Thecactusman0/ES8327-Breakout/Kicad/3D models/1.44in SPI LCD Module - No Glass.stp

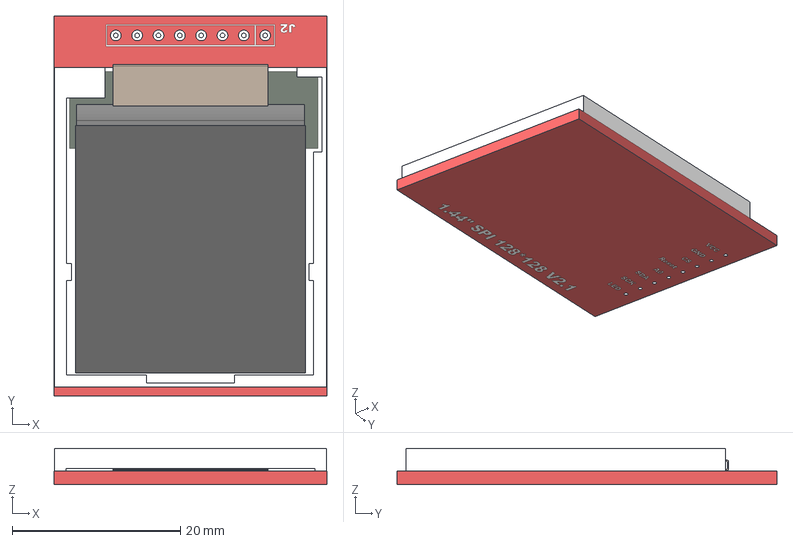
[picture p1: CAD file, 2023-06-25]
Kicad/3D models/1.44in SPI LCD Module - No Glass.stp
32.5 x 45.2 x 4.32 mm
