Thecactusman0/ES8327-Breakout/Kicad/3D models/Audio socket.step

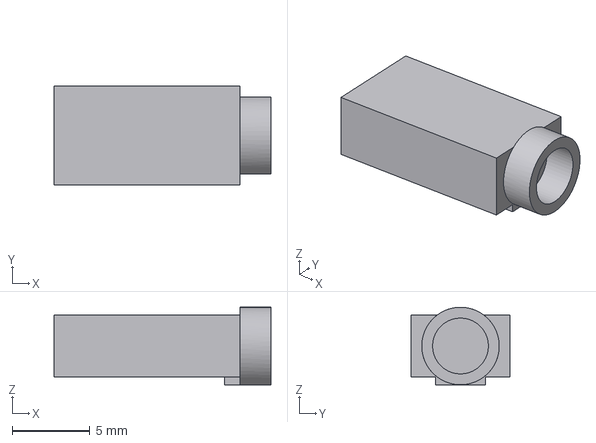
[picture p2: CAD file, 2023-06-25]
Kicad/3D models/Audio socket.step
14.0 x 6.40 x 5.00 mm
