Thecactusman0/ES8327-Breakout/Kicad/3D models/u262-16xn-4bvc11.stp

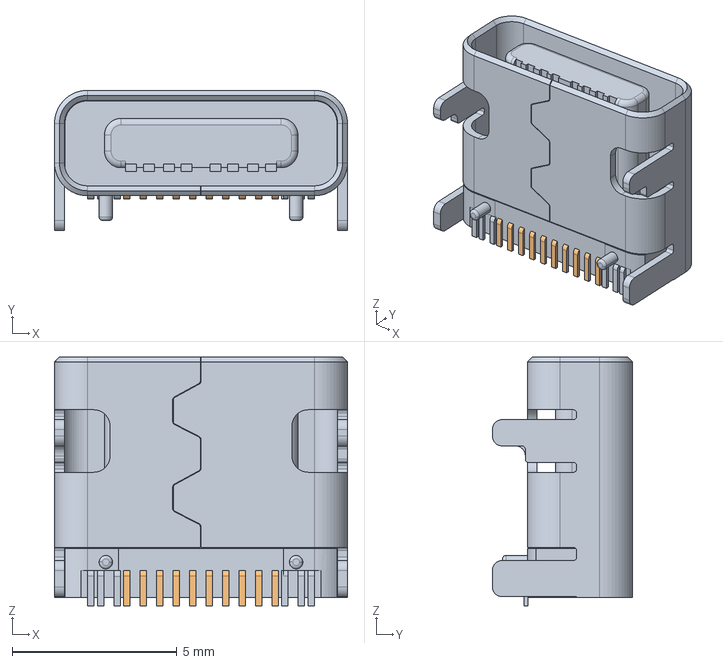
[picture p3: CAD file, 2023-06-25]
Kicad/3D models/u262-16xn-4bvc11.stp
8.90 x 4.26 x 7.56 mm
