Thecactusman0/ES8327-Breakout/Kicad/3D models/Spk.step

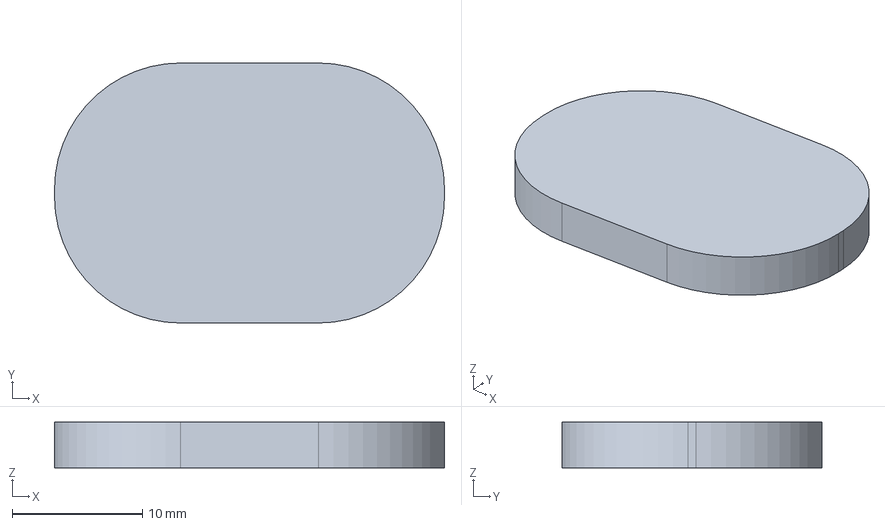
[picture p4: CAD file, 2023-06-25]
Kicad/3D models/Spk.step
30.0 x 20.0 x 3.50 mm
