Thecactusman0/ES8327-Breakout/Kicad/3D models/Mic.step

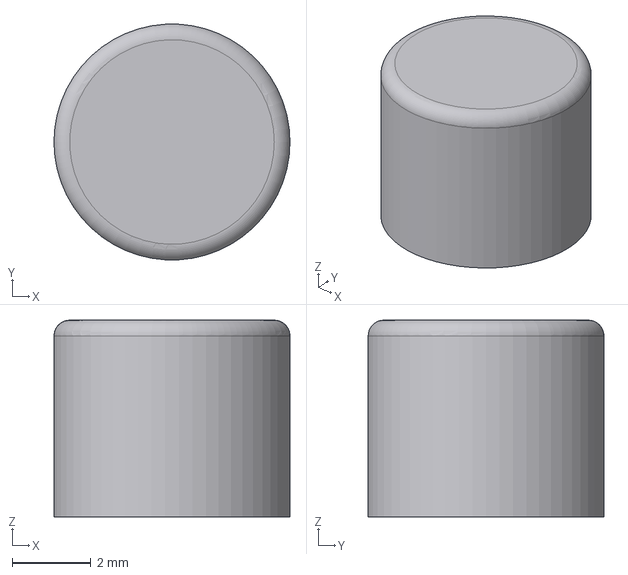
[picture p5: CAD file, 2023-06-25]
Kicad/3D models/Mic.step
6.00 x 5.99 x 5.00 mm
