Thecactusman0/ES8327-Breakout/Kicad/3D models/KMR221GLFS--3DModel-STEP-56544.STEP

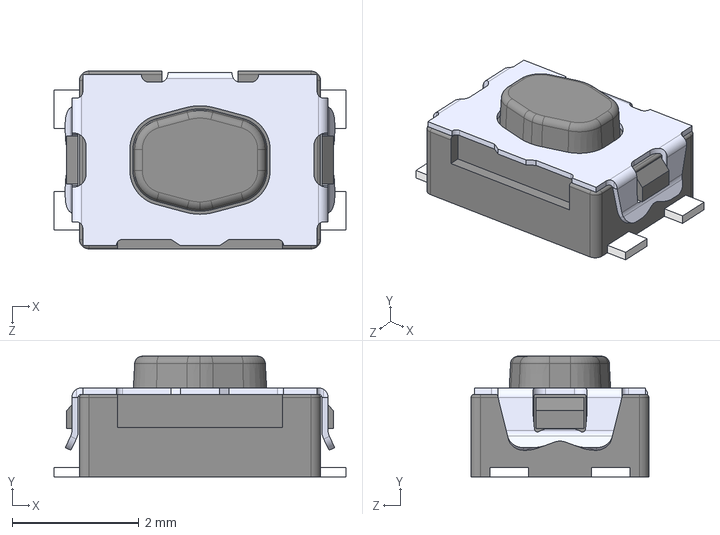
[picture p6: CAD file, 2023-06-25]
Kicad/3D models/KMR221GLFS--3DModel-STEP-56544.STEP
4.60 x 1.90 x 2.80 mm
