Thecactusman0/ES8327-Breakout/Kicad/3D models/104031-0811.stp

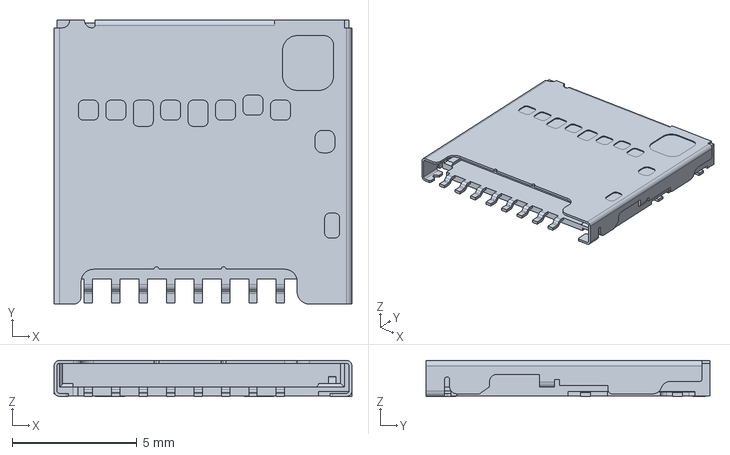
[picture p7: CAD file, 2023-06-25]
Kicad/3D models/104031-0811.stp
11.9 x 11.4 x 1.45 mm
