Thecactusman0/ES8327-Breakout/(list of files, cad)

Other CAD files:
Kicad/3D models/8967560.stp
