Thecactusman0/ES8327-Breakout/Kicad/Audio test board.kicad_sch

## KiCad design Kicad/Audio test board.kicad_sch (2023-06-25)

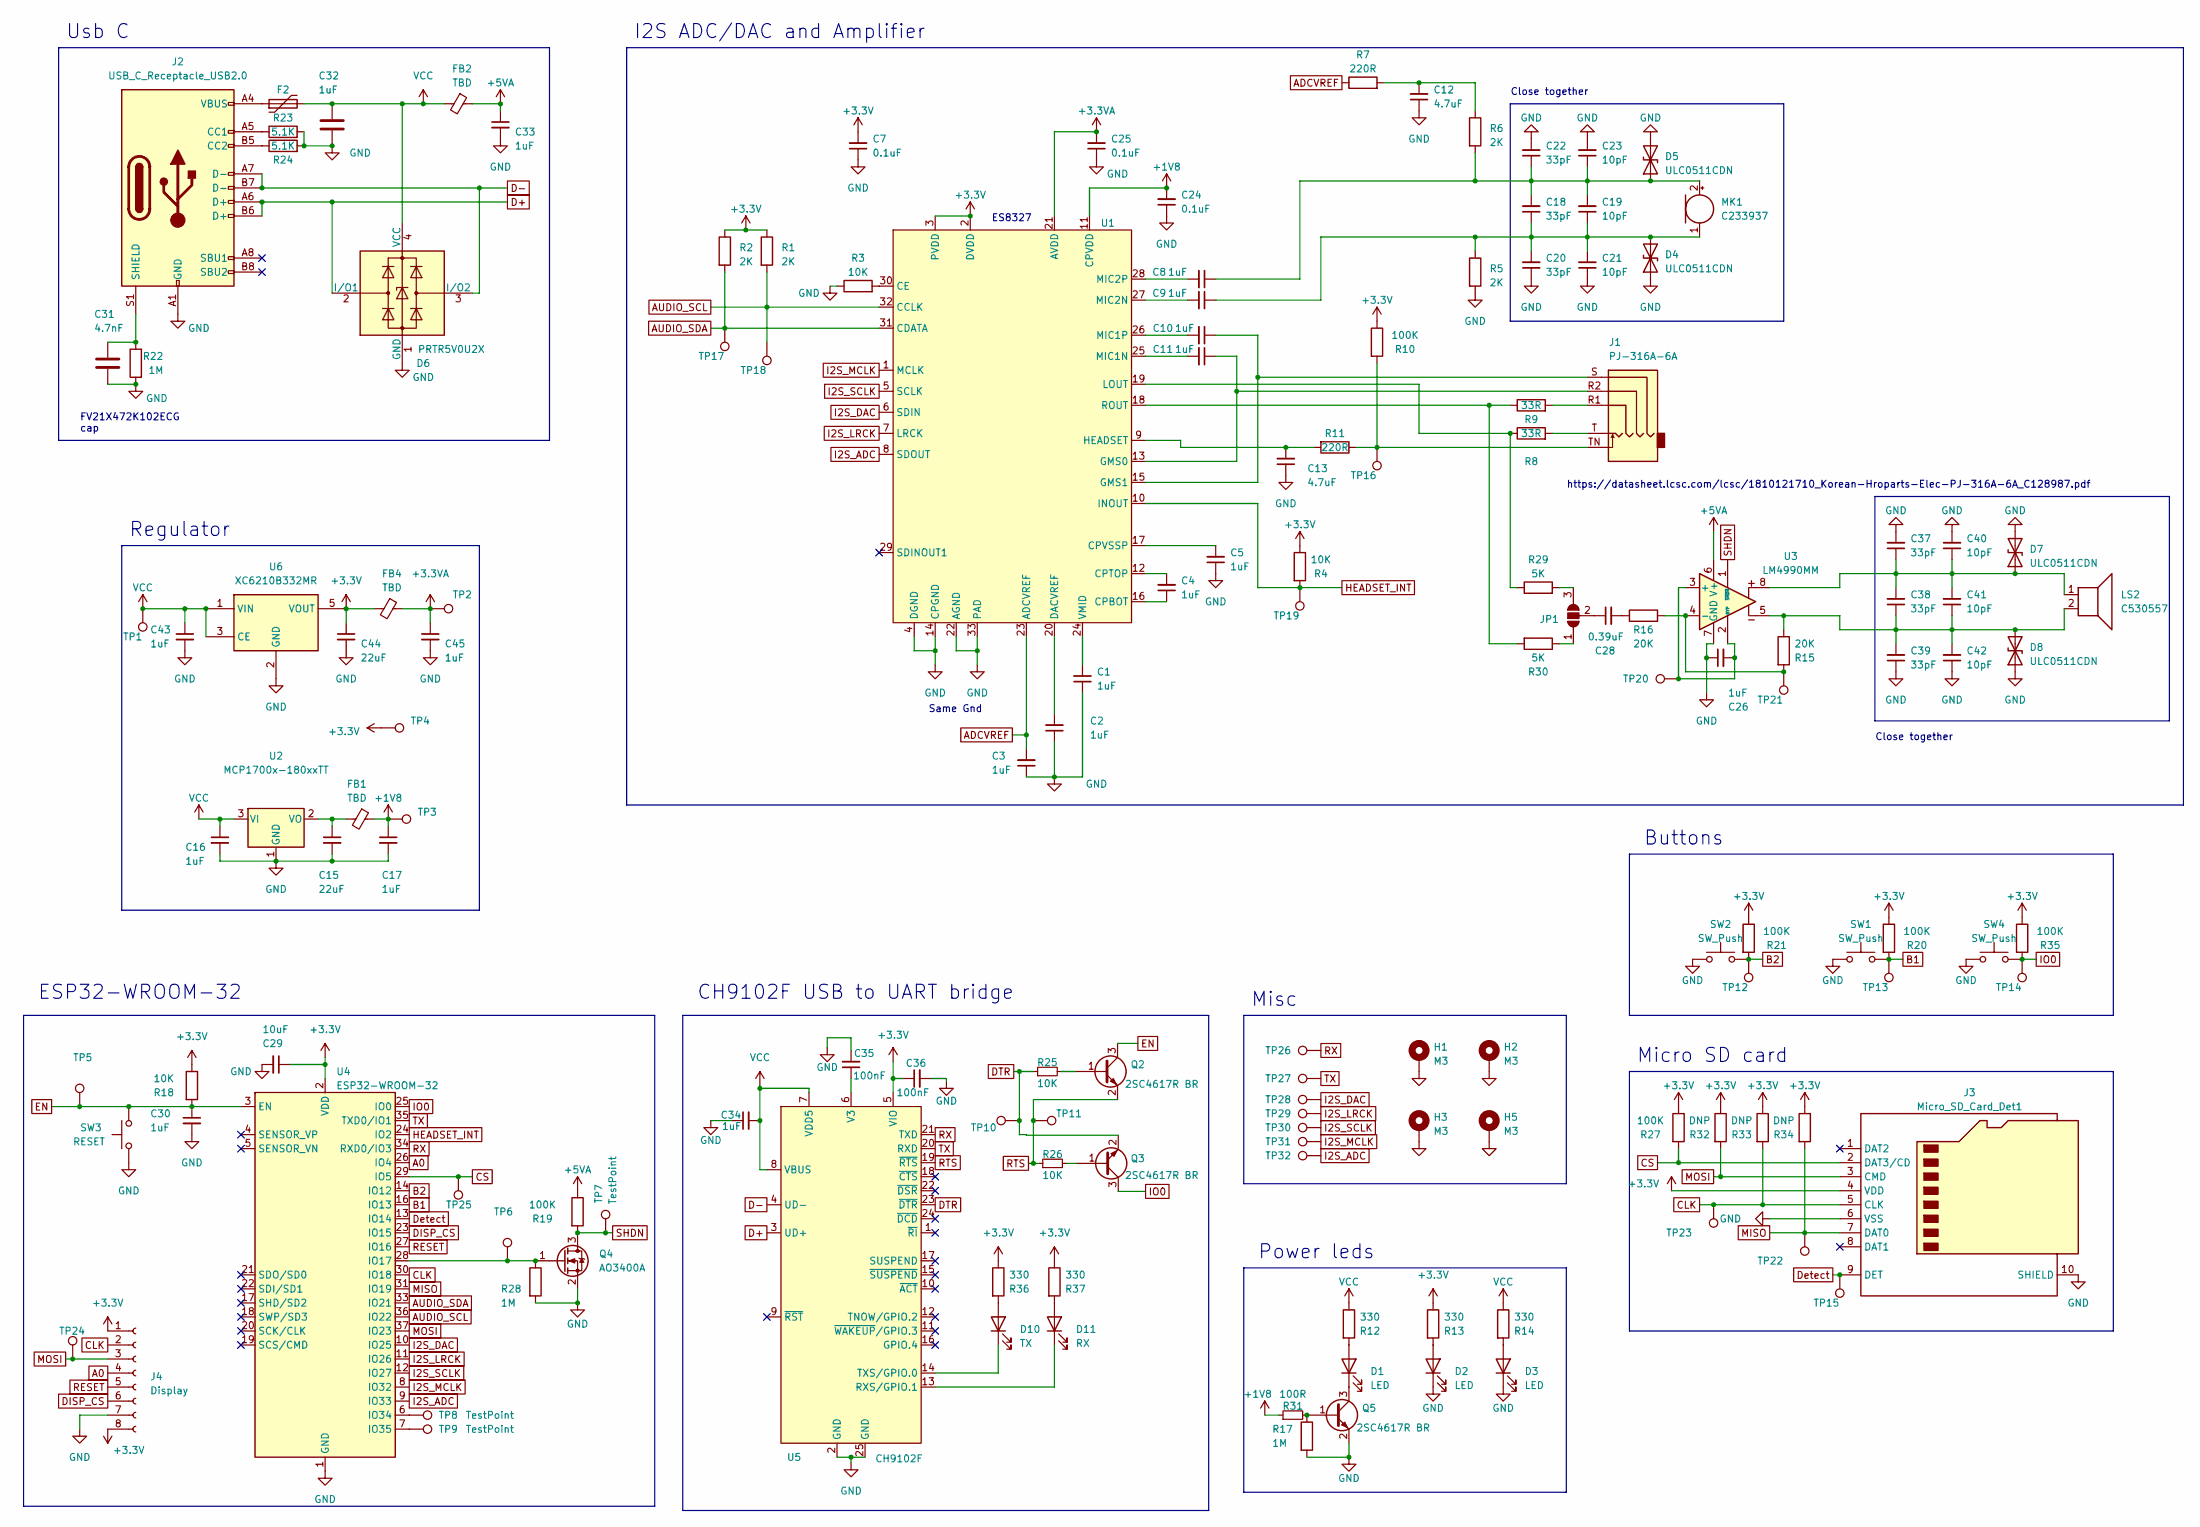
[picture p8: schematic Audio test board.kicad_sch]

Parts:
C1, C2, C3, C4, C5, C8, C9, C10, C11, C26, C32: 1uF; C_0402_1005Metric
C7, C24, C25: 0.1uF; C_0402_1005Metric
C12, C13: 4.7uF; C_0402_1005Metric
C15, C44: 22uF; C_0402_1005Metric; LCSC C14445
C16, C17, C30, C33, C43, C45: 1uF; C_0402_1005Metric; LCSC C14445
C18, C20, C22, C37, C38, C39: 33pF; C_0402_1005Metric
C19, C21, C23, C40, C41, C42: 10pF; C_0402_1005Metric
C28: 0.39uF; C_0603_1608Metric
C29: 10uF; C_0603_1608Metric; LCSC C14445
C31: 4.7nF; C_0805_2012Metric
C34: 1uF; C_0402_1005Metric; MPN 490-GRT155C80J105KE01JCT-ND
C35, C36: 100nF; C_0402_1005Metric; MPN_LCSC C258109
D1, D2, D3: LED; LED_0402_1005Metric
D4, D5, D7, D8: ULC0511CDN; DFN1006
D6: PRTR5V0U2X; SOT-143
D10: TX; LED_0402_1005Metric
D11: RX; LED_0402_1005Metric
F2: Polyfuse; Fuse_0603_1608Metric
FB1, FB2, FB4: TBD; R_0402_1005Metric
H1, H2, H3, H5: M3; MountingHole_3.2mm_M3_Pad_Via
J1: PJ-316A-6A
J2: USB_C_Receptacle_USB2.0; USB_C_Receptacle_XKB_U262-16XN-4BVC11
J3: Micro_SD_Card_Det1; microSD_HC_Molex_104031-0811
J4: Display; PinSocket_1x08_P2.54mm_Vertical
JP1: SolderJumper_3_Open; SolderJumper-3_P1.3mm_Open_RoundedPad1.0x1.5mm
LS2: C530557; batt conn
MK1: C233937; Electret mic 6mm 1.9mm pins
Q2, Q3, Q5: 2SC4617R BR; SOT-523; MPN_LCSC C2836080
Q4: AO3400A; SOT-23
R1, R2, R5, R6: 2K; R_0402_1005Metric
R3, R4, R18: 10K; R_0402_1005Metric
R7, R11: 220R; R_0402_1005Metric
R8, R9: 33R; R_0402_1005Metric
R10, R19, R20, R21, R27, R35: 100K; R_0402_1005Metric
R12, R13, R14, R36, R37: 330; R_0402_1005Metric
R15, R16: 20K; R_0402_1005Metric
R17, R22, R28: 1M; R_0402_1005Metric
R23, R24: 5.1K; R_0402_1005Metric
R25, R26: 10K; R_0402_1005Metric; MPN RMCF0402JT10K0CT-ND
R29, R30: 5K; R_0402_1005Metric
R31: 100R; R_0402_1005Metric; MPN RMCF0402JT10K0CT-ND
R32, R33, R34: DNP; R_0402_1005Metric
SW1, SW2, SW4: SW_Push; SW_Push_1P1T_NO_CK_KMR2
SW3: RESET; SW_Push_1P1T_NO_CK_KMR2
TP1, TP2, TP3, TP4, TP5, TP6, TP7, TP8, TP9, TP10, TP11, TP12, TP13, TP14, TP15, TP16, TP17, TP18, TP19, TP20, TP21, TP22, TP23, TP24, TP25, TP26, TP27, TP28, TP29, TP30, TP31, TP32: TestPoint; TestPoint_Pad_D2.0mm
U1: QFN-32-1EP_4x4mm_P0.4mm_EP2.9x2.9mm_ThermalVias
U2: MCP1700x-180xxTT; SOT-23
U3: LM4990MM; TSSOP-8_3x3mm_P0.65mm
U4: ESP32-WROOM-32
U5: CH9102F; QFN-24-1EP_4x4mm_P0.5mm_EP2.6x2.6mm; MPN_LCSC C2858418
U6: XC6210B332MR; SOT-23-5

Connections:
+1V8: C17.1, C24.2, FB1.1, R31.1, TP3.1, U1.11 (CPVDD)
+3.3V: C7.2, C29.1, C36.1, C44.1, FB4.2, J3.4 (VDD), J4.1, J4.8, R1.1, R2.1, R4.1, R10.1, R13.1, R18.1, R20.1, R21.1, R27.1, R32.1, R33.1, R34.1, R35.1, R36.1, R37.1, TP4.1, U1.2 (DVDD), U1.3 (PVDD), U4.2 (VDD), U5.5 (VIO), U6.5 (VOUT)
+3.3VA: C25.2, C45.1, FB4.1, TP2.1, U1.21 (AVDD)
+5VA: C33.1, FB2.1, R19.1, U3.6 (V+)
A0: J4.4, U4.26 (IO4)
ADCVREF: C3.2, R7.1, U1.23 (ADCVREF)
AUDIO_SCL: R1.2, TP18.1, U1.32 (CCLK), U4.36 (IO22)
AUDIO_SDA: R2.2, TP17.1, U1.31 (CDATA), U4.33 (IO21)
B1: R20.2, SW1.2, TP13.1, U4.16 (IO13)
B2: R21.2, SW2.2, TP12.1, U4.14 (IO12)
CLK: J3.5 (CLK), J4.2, R33.2, TP23.1, U4.30 (IO18)
CS: J3.2 (DAT3/CD), R27.2, TP25.1, U4.29 (IO5)
D+: D6.2 (I/O1), J2.A6 (D+), J2.B6 (D+), U5.3 (UD+)
D-: D6.3 (I/O2), J2.A7 (D-), J2.B7 (D-), U5.4 (UD-)
DISP_CS: J4.6, U4.23 (IO15)
DTR: Q3.2 (E), R25.1, TP10.1, U5.23 (~DTR)
Detect: J3.9 (DET), TP15.1, U4.13 (IO14)
EN: C30.1, Q2.3 (C), R18.2, SW3.2, TP5.1, U4.3 (EN)
GND: C1.1, C2.1, C3.1, C5.1, C7.1, C12.1, C13.1, C15.2, C16.2, C17.2, C20.1, C21.1, C22.2, C23.2, C24.1, C25.1, C26.1, C29.2, C30.2, C31.2, C32.2, C33.2, C34.1, C35.2, C36.2, C37.2, C39.1, C40.2, C42.1, C43.2, C44.2, C45.2, D2.1 (K), D3.1 (K), D4.1 (A1), D5.2 (A2), D6.1 (GND), D7.2 (A2), D8.1 (A1), H1.1, H2.1, H3.1, H5.1, J2.A1 (GND), J2.A12 (GND), J2.B1 (GND), J2.B12 (GND), J3.6 (VSS), J3.10 (SHIELD), J4.7, Q4.2 (S), Q5.2 (E), R3.1, R5.2, R17.2, R22.2, R23.2, R24.2, R28.2, SW1.1, SW2.1, SW3.1, SW4.1, U1.4 (DGND), U1.14 (CPGND), U1.22 (AGND), U1.33 (PAD), U2.1 (GND), U3.7 (GND), U4.1 (GND), U4.15 (GND), U4.38 (GND), U4.39 (GND), U5.2 (GND), U5.25 (GND), U6.2 (GND)
HEADSET_INT: R4.2, TP19.1, U1.10 (INOUT), U4.24 (IO2)
I2S_ADC: TP32.1, U1.8 (SDOUT), U4.9 (IO33)
I2S_DAC: TP28.1, U1.6 (SDIN), U4.10 (IO25)
I2S_LRCK: TP29.1, U1.7 (LRCK), U4.11 (IO26)
I2S_MCLK: TP31.1, U1.1 (MCLK), U4.8 (IO32)
I2S_SCLK: TP30.1, U1.5 (SCLK), U4.12 (IO27)
IO0: Q3.3 (C), R35.2, SW4.2, TP14.1, U4.25 (IO0)
MISO: J3.7 (DAT0), R34.2, TP22.1, U4.31 (IO19)
MOSI: J3.3 (CMD), J4.3, R32.2, TP24.1, U4.37 (IO23)
unnamed: C1.2, U1.24 (VMID)
unnamed: C2.2, U1.20 (DACVREF)
unnamed: C4.1, U1.16 (CPBOT)
unnamed: C4.2, U1.12 (CPTOP)
unnamed: C5.2, U1.17 (CPVSSP)
unnamed: C8.2, U1.28 (MIC2P)
unnamed: C9.2, U1.27 (MIC2N)
unnamed: C10.1, J1.S, U1.15 (GMS1)
unnamed: C10.2, U1.26 (MIC1P)
unnamed: C11.1, J1.R2, U1.13 (GMS0)
unnamed: C11.2, U1.25 (MIC1N)
unnamed: C12.2, R6.1, R7.2
unnamed: C13.2, R11.2, U1.9 (HEADSET)
unnamed: C15.1, FB1.2, U2.2 (VO)
unnamed: C9.1, C18.1, C19.1, C20.2, C21.2, D4.2 (A2), MK1.1 (-), R5.1
unnamed: C8.1, C18.2, C19.2, C22.1, C23.1, D5.1 (A1), MK1.2 (+), R6.2
unnamed: C26.2, TP20.1, U3.2 (BYP), U3.3 (+)
unnamed: C28.1, JP1.2 (C)
unnamed: C28.2, R16.1
unnamed: C31.1, J2.S1 (SHIELD), R22.1
unnamed: C35.1, U5.6 (V3)
unnamed: C37.1, C38.2, C40.1, C41.2, D7.1 (A1), LS2.1, U3.8
unnamed: C38.1, C39.2, C41.1, C42.2, D8.2 (A2), LS2.2, R15.1, U3.5
unnamed: D1.1 (K), Q5.3 (C)
unnamed: D1.2 (A), R12.2
unnamed: D2.2 (A), R13.2
unnamed: D3.2 (A), R14.2
unnamed: D10.1 (K), U5.14 (TXS/GPIO.0)
unnamed: D10.2 (A), R36.2
unnamed: D11.1 (K), U5.13 (RXS/GPIO.1)
unnamed: D11.2 (A), R37.2
unnamed: F2.1, J2.A4 (VBUS), J2.A9 (VBUS), J2.B4 (VBUS), J2.B9 (VBUS)
unnamed: J1.R1, R9.2
unnamed: J1.T, R8.2
unnamed: J1.TN, R10.2, R11.1, TP16.1
unnamed: J2.A5 (CC1), R23.1
unnamed: J2.B5 (CC2), R24.1
unnamed: JP1.1 (A), R30.1
unnamed: JP1.3 (B), R29.2
unnamed: Q2.1 (B), R25.2
unnamed: Q3.1 (B), R26.2
unnamed: Q4.1 (G), R28.1, TP6.1, U4.28 (IO17)
unnamed: Q5.1 (B), R17.1, R31.2
unnamed: R3.2, U1.30 (CE)
unnamed: R15.2, R16.2, TP21.1, U3.4 (-)
unnamed: R8.1, R29.1, U1.19 (LOUT)
unnamed: R9.1, R30.2, U1.18 (ROUT)
unnamed: TP8.1, U4.6 (IO34)
unnamed: TP9.1, U4.7 (IO35)
RESET: J4.5, U4.27 (IO16)
RTS: Q2.2 (E), R26.1, TP11.1, U5.19 (~RTS)
RX: TP26.1, U4.34 (RXD0/IO3), U5.21 (TXD)
SHDN: Q4.3 (D), R19.2, TP7.1, U3.1 (~SHDN)
TX: TP27.1, U4.35 (TXD0/IO1), U5.20 (RXD)
VCC: C16.1, C32.1, C34.2, C43.1, D6.4 (VCC), F2.2, FB2.2, R12.1, R14.1, TP1.1, U2.3 (VI), U5.7 (VDD5), U5.8 (VBUS), U6.1 (VIN), U6.3 (CE)

Notes on the sheet:
CH9102F USB to UART bridge
Regulator
Same Gnd
FV21X472K102ECG cap
Close together
https://datasheet.lcsc.com/lcsc/1810121710_Korean-Hroparts-Elec-PJ-316A-6A_C128987.pdf
I2S ADC/DAC and Amplifier
Power leds
ESP32-WROOM-32
Misc
Buttons
Usb C
ES8327
Micro SD card
