Thecactusman0/ES8327-Breakout/(threads)

Thread 1 (2024-12-23):

Problem

UnicornNotHorse, 2024-12-23:
I am currently using the ES8327 chip. May I ask the author how to set the clock count for this chip? I have not found any relevant information

Thecactusman0, 2024-12-23:
Im not quite sure what you mean by the chip clock count. What were you hoping to do?

UnicornNotHorse, 2024-12-23:
there is a resiger   "REGISTER 0X02-CLOCK MANAGER, DEFAULT 00000000" , If I want to use a chip to play music, how do I need to set it up

UnicornNotHorse, 2024-12-23:
Can I add your contact information

Thecactusman0, 2024-12-23:
I wrote register 0x02 as the default 00000000. Ive also got a startup sequence piece of code in my arduino es8327 library. Do you have access to the register explanations and bit mapping?

Closed 2025-01-16.
