Thecactusman0/ES8327-Breakout/(commit log)

2023-06-25 Kicad files
    [1.44in SPI LCD Module - No Glass.stp, 104031-0811.stp, 8967560.stp, Audio socket.step, Audio test board.kicad_sch, KMR221GLFS--3DModel-STEP-56544.STEP, Mic.step, Spk.step]
2023-06-25 Minor pcb update
